ToNi3141/Rasterix/screenshots/qtRasterizer.png

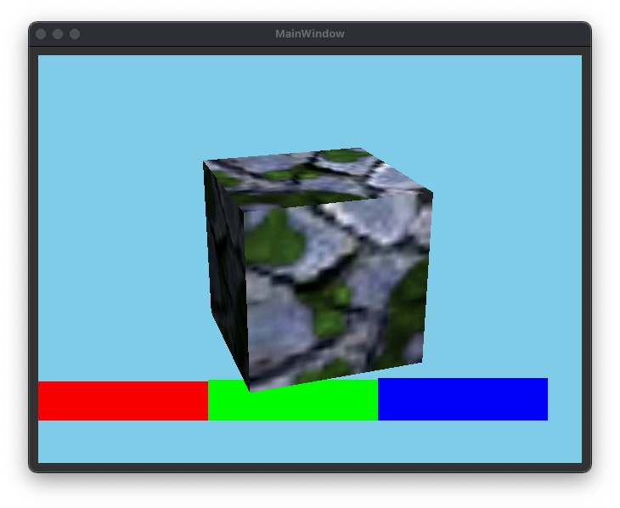
screenshots/qtRasterizer.png
