ToNi3141/Rasterix/screenshots/tuxracerRace.png

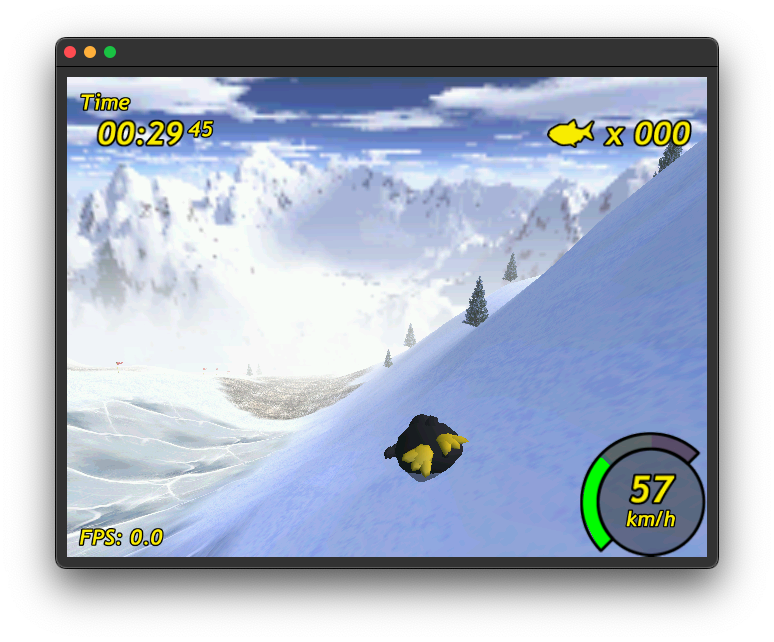
screenshots/tuxracerRace.png
