ToNi3141/Rasterix/screenshots/tuxracerRaceSelect.png

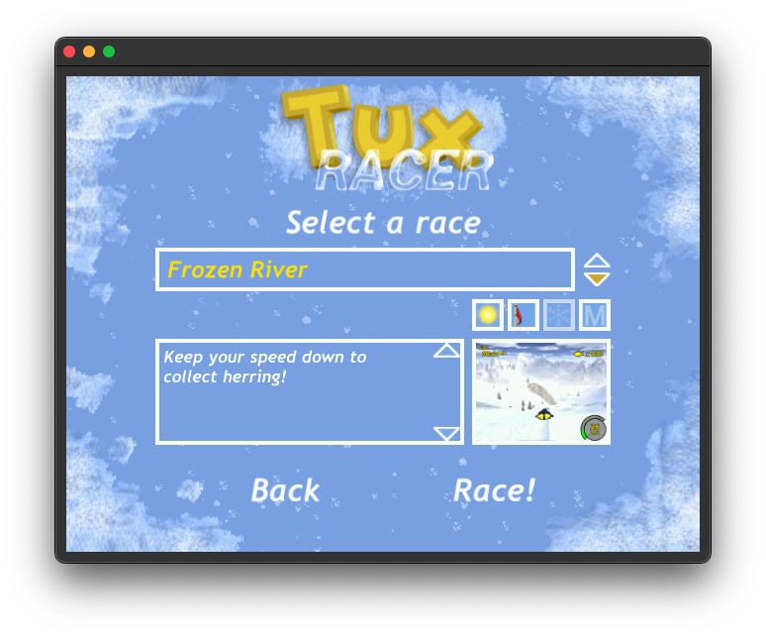
screenshots/tuxracerRaceSelect.png
