ToNi3141/Rasterix/(threads)

Thread 97 (2025-07-27):

Multiple display support, and PCIe driver

Kurapikov, 2025-07-27:
Hi ToNi3141,

I'd like to try this great project into my X64 w/ Virtex Ultrascale+ platform. Debian 12 running on X64, and the FPGA connect to X64 with PCIe Gen3 x8.

I've readed some documents in the project, and have two questions:

1. The documents no mentioned about multiple display support. Is it possible to expand? there's at least three monitors in my system and the resolution is 4k, 1080p and 720p. The drawing is not heavy, only UI and OSD. Three instance of RasterIX would be a waste of resource, IMHO.

2. Which example driver is closest to PCI express? I'm not a specialist to PCI express and kernel driver. To my knowledge, I should read the DMA proxy driver and Xilinx XDMA driver to write my one driver?

Thanks for your contribution and looking forward for your kindly reply.

BR.

ToNi3141, 2025-07-27:
Hi,
thank you for yor interest
1. Multiple displays are crrently not implemented. In theory, the hardware should be capable, adresses to the framebuffers are set via software commands, but the library itself can only draw to one context and one display. Please note that the maximum resolution is 2047x2047. 1080p should be possible (I never tested it) but 4k is not.
2. Hard to say. The DMA Proxy stuff is only useful when you want to use this project native on a Zynq or Microblaze design. The DMA Proxy is basically a driver to communicate with a DMA hardware like the CDMA from Xilinx. I guess the [ft60x ](https://github.com/ToNi3141/RasterIX/tree/main/lib/driver/ft60x) or the [raspberry pi pico example](https://github.com/ToNi3141/RasterIX/blob/main/example/util/rp-pico/Runner.hpp) should come closest to what you want.You only need a driver, which is capable to send a buffer from your Linux System via PCI to an 32Bit AXI Stream interface. More is not needed.

I hope I could help you.
Greetings
