ToNi3141/Rasterix/rtl/RasterIX/RasterIX_EF.v

// RasterIX
// https://github.com/ToNi3141/RasterIX
// Copyright (c) 2024 ToNi3141

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
module RasterIX_EF #(
    // The internal calculation width of a sub pixel
    parameter SUB_PIXEL_CALC_PRECISION = 8,

    // This enables the 4 bit stencil buffer
    parameter ENABLE_STENCIL_BUFFER = 1,

    // Enables the depth buffer
    parameter ENABLE_DEPTH_BUFFER = 1,

    // Number of TMUs. Currently supported values: 1 and 2
    parameter TMU_COUNT = 2,
    parameter ENABLE_MIPMAPPING = 1,
    parameter ENABLE_TEXTURE_FILTERING = 1,
    parameter TEXTURE_PAGE_SIZE = 2048,
    parameter ENABLE_EXTERNAL_TEXTURE_MEMORY = 0,
    parameter CACHE_SIZE = 1024,

    // Enables the fog unit
    parameter ENABLE_FOG = 1,

    // The maximum size of a texture
    parameter MAX_TEXTURE_SIZE = 256,

    // Memory address width
    parameter ADDR_WIDTH = 32,
    // Memory ID width
    parameter ID_WIDTH = 8,
    // Memory data width
    parameter DATA_WIDTH = 32,
    // Memory strobe width
    parameter STRB_WIDTH = DATA_WIDTH / 8,
    // Enable coalescing of the memory beats. This can significantly improve the throughput.
    parameter ENABLE_MEMORY_COALESCING = 1,

    // Configures the precision of the float calculations (interpolation of textures, depth, ...)
    // A lower value can significant reduce the logic consumption but can cause visible 
    // distortions in the rendered image.
    // 4 bit reducing can safe around 1k LUTs.
    // For compatibility reasons, it only cuts of the mantissa. By default it uses a 25x25 multiplier (for floatMul)
    // If you have a FPGA with only 18 bit native multipliers, reduce this value to 26.
    parameter RASTERIZER_FLOAT_PRECISION = 32,
    // When RASTERIZER_ENABLE_FLOAT_INTERPOLATION is 0, then this configures the width of the multipliers for the fix point
    // calculations. A value of 25 will instantiate signed 25 bit multipliers. The 25 already including the sign bit.
    // Lower values can lead to distortions of the fog and texels.
    parameter RASTERIZER_FIXPOINT_PRECISION = 25,
    // Enables the floating point interpolation. If this is disabled, it falls back
    // to the fix point interpolation
    parameter RASTERIZER_ENABLE_FLOAT_INTERPOLATION = 0,

    localparam CMD_STREAM_WIDTH = 32,
    localparam FB_SIZE_IN_PIXEL_LG = 20
)
(
    input  wire                             aclk,
    input  wire                             resetn,

    // AXI Stream command interface
    input  wire                             s_cmd_axis_tvalid,
    output wire                             s_cmd_axis_tready,
    input  wire                             s_cmd_axis_tlast,
    input  wire [CMD_STREAM_WIDTH - 1 : 0]  s_cmd_axis_tdata,

    // AXI Stream command response interface
    output wire                             m_cmd_resp_axis_tvalid,
    input  wire                             m_cmd_resp_axis_tready,
    output wire                             m_cmd_resp_axis_tlast,
    output wire [CMD_STREAM_WIDTH - 1 : 0]  m_cmd_resp_axis_tdata,

    // Framebuffer
    output wire                             swap_fb,
    output wire                             swap_fb_enable_vsync,
    output wire [ADDR_WIDTH - 1 : 0]        fb_addr,
    output wire [FB_SIZE_IN_PIXEL_LG - 1 : 0] fb_size,
    input  wire                             fb_swapped,

    // Memory Interface
    output wire [ID_WIDTH - 1 : 0]          m_axi_awid,
    output wire [ADDR_WIDTH - 1 : 0]        m_axi_awaddr,
    output wire [ 7 : 0]                    m_axi_awlen,
    output wire [ 2 : 0]                    m_axi_awsize,
    output wire [ 1 : 0]                    m_axi_awburst,
    output wire                             m_axi_awlock,
    output wire [ 3 : 0]                    m_axi_awcache,
    output wire [ 2 : 0]                    m_axi_awprot,
    output wire                             m_axi_awvalid,
    input  wire                             m_axi_awready,
    output wire [DATA_WIDTH - 1 : 0]        m_axi_wdata,
    output wire [STRB_WIDTH - 1 : 0]        m_axi_wstrb,
    output wire                             m_axi_wlast,
    output wire                             m_axi_wvalid,
    input  wire                             m_axi_wready,
    input  wire [ID_WIDTH - 1 : 0]          m_axi_bid,
    input  wire [ 1 : 0]                    m_axi_bresp,
    input  wire                             m_axi_bvalid,
    output wire                             m_axi_bready,
    output wire [ID_WIDTH - 1 : 0]          m_axi_arid,
    output wire [ADDR_WIDTH - 1 : 0]        m_axi_araddr,
    output wire [ 7 : 0]                    m_axi_arlen,
    output wire [ 2 : 0]                    m_axi_arsize,
    output wire [ 1 : 0]                    m_axi_arburst,
    output wire                             m_axi_arlock,
    output wire [ 3 : 0]                    m_axi_arcache,
    output wire [ 2 : 0]                    m_axi_arprot,
    output wire                             m_axi_arvalid,
    input  wire                             m_axi_arready,
    input  wire [ID_WIDTH - 1 : 0]          m_axi_rid,
    input  wire [DATA_WIDTH - 1 : 0]        m_axi_rdata,
    input  wire [ 1 : 0]                    m_axi_rresp,
    input  wire                             m_axi_rlast,
    input  wire                             m_axi_rvalid,
    output wire                             m_axi_rready,

    // Performance signals
    output wire                             perfBusy,
    output wire                             perfTriangleRendering,
    output wire                             perfRasterizerStall
);
    localparam ID_WIDTH_LOC = ID_WIDTH - 3;
    localparam NRS = 6;

    initial
    begin
        if (ID_WIDTH < 4)
        begin
            $error("ID_WIDTH must be at least 4");
        end
    end

    wire [(NRS * ID_WIDTH_LOC) - 1 : 0]     xbar_axi_awid;
    wire [(NRS * ADDR_WIDTH) - 1 : 0]       xbar_axi_awaddr;
    wire [(NRS * 8) - 1 : 0]                xbar_axi_awlen; 
    wire [(NRS * 3) - 1 : 0]                xbar_axi_awsize;
    wire [(NRS * 2) - 1 : 0]                xbar_axi_awburst;
    wire [NRS - 1 : 0]                      xbar_axi_awlock;
    wire [(NRS * 4) - 1 : 0]                xbar_axi_awcache;
    wire [(NRS * 3) - 1 : 0]                xbar_axi_awprot; 
    wire [NRS - 1 : 0]                      xbar_axi_awvalid;
    wire [NRS - 1 : 0]                      xbar_axi_awready;

    wire [(NRS * DATA_WIDTH) - 1 : 0]       xbar_axi_wdata;
    wire [(NRS * STRB_WIDTH) - 1 : 0]       xbar_axi_wstrb;
    wire [NRS - 1 : 0]                      xbar_axi_wlast;
    wire [NRS - 1 : 0]                      xbar_axi_wvalid;
    wire [NRS - 1 : 0]                      xbar_axi_wready;

    wire [(NRS * ID_WIDTH_LOC) - 1 : 0]     xbar_axi_bid;
    wire [(NRS * 2) - 1 : 0]                xbar_axi_bresp;
    wire [NRS - 1 : 0]                      xbar_axi_bvalid;
    wire [NRS - 1 : 0]                      xbar_axi_bready;

    wire [(NRS * ID_WIDTH_LOC) - 1 : 0]     xbar_axi_arid;
    wire [(NRS * ADDR_WIDTH) - 1 : 0]       xbar_axi_araddr;
    wire [(NRS * 8) - 1 : 0]                xbar_axi_arlen;
    wire [(NRS * 3) - 1 : 0]                xbar_axi_arsize;
    wire [(NRS * 2) - 1 : 0]                xbar_axi_arburst;
    wire [NRS - 1 : 0]                      xbar_axi_arlock;
    wire [(NRS * 4) - 1 : 0]                xbar_axi_arcache;
    wire [(NRS * 3) - 1 : 0]                xbar_axi_arprot;
    wire [NRS - 1 : 0]                      xbar_axi_arvalid;
    wire [NRS - 1 : 0]                      xbar_axi_arready;

    wire [(NRS * ID_WIDTH_LOC) - 1 : 0]     xbar_axi_rid;
    wire [(NRS * DATA_WIDTH) - 1 : 0]       xbar_axi_rdata;
    wire [(NRS * 2) - 1 : 0]                xbar_axi_rresp;
    wire [NRS - 1 : 0]                      xbar_axi_rlast;
    wire [NRS - 1 : 0]                      xbar_axi_rvalid;
    wire [NRS - 1 : 0]                      xbar_axi_rready;

    axi_crossbar #(
        .DATA_WIDTH(DATA_WIDTH),
        .ADDR_WIDTH(ADDR_WIDTH),
        .S_ID_WIDTH(ID_WIDTH_LOC),
        .S_COUNT(NRS),
        .M_COUNT(1),
        .M_ID_WIDTH(ID_WIDTH),
        .M_ADDR_WIDTH(ADDR_WIDTH[0 +: 32]),
        .S_THREADS({ NRS { 32'd1 } }),
        .M_ISSUE(32'd8) // Best tradeoff between performance and utilization
    ) mainXBar (
        .clk(aclk),
        .rst(!resetn),

        .s_axi_awid(xbar_axi_awid),
        .s_axi_awaddr(xbar_axi_awaddr),
        .s_axi_awlen(xbar_axi_awlen),
        .s_axi_awsize(xbar_axi_awsize),
        .s_axi_awburst(xbar_axi_awburst),
        .s_axi_awlock(xbar_axi_awlock),
        .s_axi_awcache(xbar_axi_awcache),
        .s_axi_awprot(xbar_axi_awprot),
        .s_axi_awqos(0),
        .s_axi_awuser(0),
        .s_axi_awvalid(xbar_axi_awvalid),
        .s_axi_awready(xbar_axi_awready),

        .s_axi_wdata(xbar_axi_wdata),
        .s_axi_wstrb(xbar_axi_wstrb),
        .s_axi_wlast(xbar_axi_wlast),
        .s_axi_wuser(0),
        .s_axi_wvalid(xbar_axi_wvalid),
        .s_axi_wready(xbar_axi_wready),

        .s_axi_bid(xbar_axi_bid),
        .s_axi_bresp(xbar_axi_bresp),
        .s_axi_buser(),
        .s_axi_bvalid(xbar_axi_bvalid),
        .s_axi_bready(xbar_axi_bready),

        .s_axi_arid(xbar_axi_arid),
        .s_axi_araddr(xbar_axi_araddr),
        .s_axi_arlen(xbar_axi_arlen),
        .s_axi_arsize(xbar_axi_arsize),
        .s_axi_arburst(xbar_axi_arburst),
        .s_axi_arlock(xbar_axi_arlock),
        .s_axi_arcache(xbar_axi_arcache),
        .s_axi_arprot(xbar_axi_arprot),
        .s_axi_arqos(0),
        .s_axi_aruser(0),
        .s_axi_arvalid(xbar_axi_arvalid),
        .s_axi_arready(xbar_axi_arready),

        .s_axi_rid(xbar_axi_rid),
        .s_axi_rdata(xbar_axi_rdata),
        .s_axi_rresp(xbar_axi_rresp),
        .s_axi_rlast(xbar_axi_rlast),
        .s_axi_ruser(),
        .s_axi_rvalid(xbar_axi_rvalid),
        .s_axi_rready(xbar_axi_rready),

        .m_axi_awid(m_axi_awid),
        .m_axi_awaddr(m_axi_awaddr),
        .m_axi_awlen(m_axi_awlen),
        .m_axi_awsize(m_axi_awsize),
        .m_axi_awburst(m_axi_awburst),
        .m_axi_awlock(m_axi_awlock),
        .m_axi_awcache(m_axi_awcache),
        .m_axi_awprot(m_axi_awprot),
        .m_axi_awqos(),
        .m_axi_awregion(),
        .m_axi_awuser(),
        .m_axi_awvalid(m_axi_awvalid),
        .m_axi_awready(m_axi_awready),

        .m_axi_wdata(m_axi_wdata),
        .m_axi_wstrb(m_axi_wstrb),
        .m_axi_wlast(m_axi_wlast),
        .m_axi_wuser(),
        .m_axi_wvalid(m_axi_wvalid),
        .m_axi_wready(m_axi_wready),

        .m_axi_bid(m_axi_bid),
        .m_axi_bresp(m_axi_bresp),
        .m_axi_buser(0),
        .m_axi_bvalid(m_axi_bvalid),
        .m_axi_bready(m_axi_bready),

        .m_axi_arid(m_axi_arid),
        .m_axi_araddr(m_axi_araddr),
        .m_axi_arlen(m_axi_arlen),
        .m_axi_arsize(m_axi_arsize),
        .m_axi_arburst(m_axi_arburst),
        .m_axi_arlock(m_axi_arlock),
        .m_axi_arcache(m_axi_arcache),
        .m_axi_arqos(),
        .m_axi_arregion(),
        .m_axi_aruser(),
        .m_axi_arprot(m_axi_arprot),
        .m_axi_arvalid(m_axi_arvalid),
        .m_axi_arready(m_axi_arready),

        .m_axi_rid(m_axi_rid),
        .m_axi_rdata(m_axi_rdata),
        .m_axi_rresp(m_axi_rresp),
        .m_axi_rlast(m_axi_rlast),
        .m_axi_ruser(0),
        .m_axi_rvalid(m_axi_rvalid),
        .m_axi_rready(m_axi_rready)
    );

    localparam CMD_STREAM_STRB_WIDTH = CMD_STREAM_WIDTH / 8;
    wire [ID_WIDTH_LOC - 1 : 0]             common_axi_awid;
    wire [ADDR_WIDTH - 1 : 0]               common_axi_awaddr;
    wire [ 7 : 0]                           common_axi_awlen;
    wire [ 2 : 0]                           common_axi_awsize;
    wire [ 1 : 0]                           common_axi_awburst;
    wire                                    common_axi_awlock;
    wire [ 3 : 0]                           common_axi_awcache;
    wire [ 2 : 0]                           common_axi_awprot;
    wire                                    common_axi_awvalid;
    wire                                    common_axi_awready;
    wire [CMD_STREAM_WIDTH - 1 : 0]         common_axi_wdata;
    wire [CMD_STREAM_STRB_WIDTH - 1 : 0]    common_axi_wstrb;
    wire                                    common_axi_wlast;
    wire                                    common_axi_wvalid;
    wire                                    common_axi_wready;
    wire [ID_WIDTH_LOC - 1 : 0]             common_axi_bid;
    wire [ 1 : 0]                           common_axi_bresp;
    wire                                    common_axi_bvalid;
    wire                                    common_axi_bready;
    wire [ID_WIDTH_LOC - 1 : 0]             common_axi_arid;
    wire [ADDR_WIDTH - 1 : 0]               common_axi_araddr;
    wire [ 7 : 0]                           common_axi_arlen;
    wire [ 2 : 0]                           common_axi_arsize;
    wire [ 1 : 0]                           common_axi_arburst;
    wire                                    common_axi_arlock;
    wire [ 3 : 0]                           common_axi_arcache;
    wire [ 2 : 0]                           common_axi_arprot;
    wire                                    common_axi_arvalid;
    wire                                    common_axi_arready;
    wire [ID_WIDTH_LOC - 1 : 0]             common_axi_rid;
    wire [CMD_STREAM_WIDTH - 1 : 0]         common_axi_rdata;
    wire [ 1 : 0]                           common_axi_rresp;
    wire                                    common_axi_rlast;
    wire                                    common_axi_rvalid;
    wire                                    common_axi_rready;

    axi_adapter #(
        .ADDR_WIDTH(ADDR_WIDTH),
        .M_DATA_WIDTH(DATA_WIDTH),
        .M_STRB_WIDTH(STRB_WIDTH),
        .S_DATA_WIDTH(CMD_STREAM_WIDTH),
        .S_STRB_WIDTH(CMD_STREAM_STRB_WIDTH),
        .ID_WIDTH(ID_WIDTH_LOC),
        .CONVERT_BURST(1),
        .CONVERT_NARROW_BURST(1)
    ) commonAxiAdapter (
        .clk(aclk),
        .rst(!resetn),

        .m_axi_awid(xbar_axi_awid[0 * ID_WIDTH_LOC +: ID_WIDTH_LOC]),
        .m_axi_awaddr(xbar_axi_awaddr[0 * ADDR_WIDTH +: ADDR_WIDTH]),
        .m_axi_awlen(xbar_axi_awlen[0 * 8 +: 8]),
        .m_axi_awsize(xbar_axi_awsize[0 * 3 +: 3]),
        .m_axi_awburst(xbar_axi_awburst[0 * 2 +: 2]),
        .m_axi_awlock(xbar_axi_awlock[0 * 1 +: 1]),
        .m_axi_awcache(xbar_axi_awcache[0 * 4 +: 4]),
        .m_axi_awprot(xbar_axi_awprot[0 * 3 +: 3]),
        .m_axi_awqos(),
        .m_axi_awregion(),
        .m_axi_awuser(),
        .m_axi_awvalid(xbar_axi_awvalid[0 * 1 +: 1]),
        .m_axi_awready(xbar_axi_awready[0 * 1 +: 1]),
        .m_axi_wdata(xbar_axi_wdata[0 * DATA_WIDTH +: DATA_WIDTH]),
        .m_axi_wstrb(xbar_axi_wstrb[0 * STRB_WIDTH +: STRB_WIDTH]),
        .m_axi_wlast(xbar_axi_wlast[0 * 1 +: 1]),
        .m_axi_wuser(),
        .m_axi_wvalid(xbar_axi_wvalid[0 * 1 +: 1]),
        .m_axi_wready(xbar_axi_wready[0 * 1 +: 1]),
        .m_axi_bid(xbar_axi_bid[0 * ID_WIDTH_LOC +: ID_WIDTH_LOC]),
        .m_axi_bresp(xbar_axi_bresp[0 * 2 +: 2]),
        .m_axi_buser(0),
        .m_axi_bvalid(xbar_axi_bvalid[0 * 1 +: 1]),
        .m_axi_bready(xbar_axi_bready[0 * 1 +: 1]),
        .m_axi_arid(xbar_axi_arid[0 * ID_WIDTH_LOC +: ID_WIDTH_LOC]),
        .m_axi_araddr(xbar_axi_araddr[0 * ADDR_WIDTH +: ADDR_WIDTH]),
        .m_axi_arlen(xbar_axi_arlen[0 * 8 +: 8]),
        .m_axi_arsize(xbar_axi_arsize[0 * 3 +: 3]),
        .m_axi_arburst(xbar_axi_arburst[0 * 2 +: 2]),
        .m_axi_arlock(xbar_axi_arlock[0 * 1 +: 1]),
        .m_axi_arcache(xbar_axi_arcache[0 * 4 +: 4]),
        .m_axi_arprot(xbar_axi_arprot[0 * 3 +: 3]),
        .m_axi_arqos(),
        .m_axi_arregion(),
        .m_axi_aruser(),
        .m_axi_arvalid(xbar_axi_arvalid[0 * 1 +: 1]),
        .m_axi_arready(xbar_axi_arready[0 * 1 +: 1]),
        .m_axi_rid(xbar_axi_rid[0 * ID_WIDTH_LOC +: ID_WIDTH_LOC]),
        .m_axi_rdata(xbar_axi_rdata[0 * DATA_WIDTH +: DATA_WIDTH]),
        .m_axi_rresp(xbar_axi_rresp[0 * 2 +: 2]),
        .m_axi_rlast(xbar_axi_rlast[0 * 1 +: 1]),
        .m_axi_ruser(0),
        .m_axi_rvalid(xbar_axi_rvalid[0 * 1 +: 1]),
        .m_axi_rready(xbar_axi_rready[0 * 1 +: 1]),

        .s_axi_awid(common_axi_awid),
        .s_axi_awaddr(common_axi_awaddr),
        .s_axi_awlen(common_axi_awlen),
        .s_axi_awsize(common_axi_awsize),
        .s_axi_awburst(common_axi_awburst),
        .s_axi_awlock(common_axi_awlock),
        .s_axi_awcache(common_axi_awcache),
        .s_axi_awprot(common_axi_awprot),
        .s_axi_awqos(0),
        .s_axi_awregion(0),
        .s_axi_awuser(0),
        .s_axi_awvalid(common_axi_awvalid),
        .s_axi_awready(common_axi_awready),
        .s_axi_wdata(common_axi_wdata),
        .s_axi_wstrb(common_axi_wstrb),
        .s_axi_wlast(common_axi_wlast),
        .s_axi_wuser(0),
        .s_axi_wvalid(common_axi_wvalid),
        .s_axi_wready(common_axi_wready),
        .s_axi_bid(common_axi_bid),
        .s_axi_bresp(common_axi_bresp),
        .s_axi_buser(),
        .s_axi_bvalid(common_axi_bvalid),
        .s_axi_bready(common_axi_bready),
        .s_axi_arid(common_axi_arid),
        .s_axi_araddr(common_axi_araddr),
        .s_axi_arlen(common_axi_arlen),
        .s_axi_arsize(common_axi_arsize),
        .s_axi_arburst(common_axi_arburst),
        .s_axi_arlock(common_axi_arlock),
        .s_axi_arcache(common_axi_arcache),
        .s_axi_arprot(common_axi_arprot),
        .s_axi_arqos(0),
        .s_axi_arregion(0),
        .s_axi_aruser(0),
        .s_axi_arvalid(common_axi_arvalid),
        .s_axi_arready(common_axi_arready),
        .s_axi_rid(common_axi_rid),
        .s_axi_rdata(common_axi_rdata),
        .s_axi_rresp(common_axi_rresp),
        .s_axi_rlast(common_axi_rlast),
        .s_axi_ruser(),
        .s_axi_rvalid(common_axi_rvalid),
        .s_axi_rready(common_axi_rready)
    );

    wire                             cmd_axis_tvalid;
    wire                             cmd_axis_tready;
    wire                             cmd_axis_tlast;
    wire [CMD_STREAM_WIDTH - 1 : 0]  cmd_axis_tdata;

    FrameStreamingCore #(
        .STREAM_WIDTH(CMD_STREAM_WIDTH),
        .ADDR_WIDTH(ADDR_WIDTH),
        .ID_WIDTH(ID_WIDTH_LOC)
    ) dma (
        .aclk(aclk),
        .resetn(resetn),

        .m_st1_axis_tvalid(cmd_axis_tvalid),
        .m_st1_axis_tready(cmd_axis_tready),
        .m_st1_axis_tlast(cmd_axis_tlast),
        .m_st1_axis_tdata(cmd_axis_tdata),

        .s_st1_axis_tvalid(0),
        .s_st1_axis_tready(),
        .s_st1_axis_tlast(0),
        .s_st1_axis_tdata(0),

        .m_st0_axis_tvalid(m_cmd_resp_axis_tvalid),
        .m_st0_axis_tready(m_cmd_resp_axis_tready),
        .m_st0_axis_tlast(m_cmd_resp_axis_tlast),
        .m_st0_axis_tdata(m_cmd_resp_axis_tdata),

        .s_st0_axis_tvalid(s_cmd_axis_tvalid),
        .s_st0_axis_tready(s_cmd_axis_tready),
        .s_st0_axis_tlast(s_cmd_axis_tlast),
        .s_st0_axis_tdata(s_cmd_axis_tdata),

        .m_mem_axi_awid(common_axi_awid),
        .m_mem_axi_awaddr(common_axi_awaddr),
        .m_mem_axi_awlen(common_axi_awlen), 
        .m_mem_axi_awsize(common_axi_awsize), 
        .m_mem_axi_awburst(common_axi_awburst), 
        .m_mem_axi_awlock(common_axi_awlock), 
        .m_mem_axi_awcache(common_axi_awcache), 
        .m_mem_axi_awprot(common_axi_awprot), 
        .m_mem_axi_awvalid(common_axi_awvalid),
        .m_mem_axi_awready(common_axi_awready),

        .m_mem_axi_wdata(common_axi_wdata),
        .m_mem_axi_wstrb(common_axi_wstrb),
        .m_mem_axi_wlast(common_axi_wlast),
        .m_mem_axi_wvalid(common_axi_wvalid),
        .m_mem_axi_wready(common_axi_wready),

        .m_mem_axi_bid(common_axi_bid),
        .m_mem_axi_bresp(common_axi_bresp),
        .m_mem_axi_bvalid(common_axi_bvalid),
        .m_mem_axi_bready(common_axi_bready),

        .m_mem_axi_arid(common_axi_arid),
        .m_mem_axi_araddr(common_axi_araddr),
        .m_mem_axi_arlen(common_axi_arlen),
        .m_mem_axi_arsize(common_axi_arsize),
        .m_mem_axi_arburst(common_axi_arburst),
        .m_mem_axi_arlock(common_axi_arlock),
        .m_mem_axi_arcache(common_axi_arcache),
        .m_mem_axi_arprot(common_axi_arprot),
        .m_mem_axi_arvalid(common_axi_arvalid),
        .m_mem_axi_arready(common_axi_arready),

        .m_mem_axi_rid(common_axi_rid),
        .m_mem_axi_rdata(common_axi_rdata),
        .m_mem_axi_rresp(common_axi_rresp),
        .m_mem_axi_rlast(common_axi_rlast),
        .m_mem_axi_rvalid(common_axi_rvalid),
        .m_mem_axi_rready(common_axi_rready)
    );

    RasterIXCoreEF #(
        .TEXTURE_PAGE_SIZE(TEXTURE_PAGE_SIZE),
        .ADDR_WIDTH(ADDR_WIDTH),
        .ID_WIDTH(ID_WIDTH_LOC),
        .DATA_WIDTH(DATA_WIDTH),
        .SUB_PIXEL_CALC_PRECISION(SUB_PIXEL_CALC_PRECISION),
        .ENABLE_STENCIL_BUFFER(ENABLE_STENCIL_BUFFER),
        .ENABLE_DEPTH_BUFFER(ENABLE_DEPTH_BUFFER),
        .MAX_TEXTURE_SIZE(MAX_TEXTURE_SIZE),
        .ENABLE_MIPMAPPING(ENABLE_MIPMAPPING),
        .ENABLE_TEXTURE_FILTERING(ENABLE_TEXTURE_FILTERING),
        .ENABLE_EXTERNAL_TEXTURE_MEMORY(ENABLE_EXTERNAL_TEXTURE_MEMORY),
        .CACHE_SIZE(CACHE_SIZE),
        .ENABLE_FOG(ENABLE_FOG),
        .TMU_COUNT(TMU_COUNT),
        .RASTERIZER_ENABLE_FLOAT_INTERPOLATION(RASTERIZER_ENABLE_FLOAT_INTERPOLATION),
        .RASTERIZER_FLOAT_PRECISION(RASTERIZER_FLOAT_PRECISION),
        .RASTERIZER_FIXPOINT_PRECISION(RASTERIZER_FIXPOINT_PRECISION),
        .ENABLE_MEMORY_COALESCING(ENABLE_MEMORY_COALESCING)
    ) rixef (
        .aclk(aclk),
        .resetn(resetn),
        
        .s_cmd_axis_tvalid(cmd_axis_tvalid),
        .s_cmd_axis_tready(cmd_axis_tready),
        .s_cmd_axis_tlast(cmd_axis_tlast),
        .s_cmd_axis_tdata(cmd_axis_tdata),

        .swap_fb(swap_fb),
        .swap_fb_enable_vsync(swap_fb_enable_vsync),
        .fb_addr(fb_addr),
        .fb_size(fb_size),
        .fb_swapped(fb_swapped),

        .m_color_axi_awid(xbar_axi_awid[1 * ID_WIDTH_LOC +: ID_WIDTH_LOC]),
        .m_color_axi_awaddr(xbar_axi_awaddr[1 * ADDR_WIDTH +: ADDR_WIDTH]),
        .m_color_axi_awlen(xbar_axi_awlen[1 * 8 +: 8]),
        .m_color_axi_awsize(xbar_axi_awsize[1 * 3 +: 3]),
        .m_color_axi_awburst(xbar_axi_awburst[1 * 2 +: 2]),
        .m_color_axi_awlock(xbar_axi_awlock[1 * 1 +: 1]),
        .m_color_axi_awcache(xbar_axi_awcache[1 * 4 +: 4]),
        .m_color_axi_awprot(xbar_axi_awprot[1 * 3 +: 3]),
        .m_color_axi_awvalid(xbar_axi_awvalid[1 * 1 +: 1]),
        .m_color_axi_awready(xbar_axi_awready[1 * 1 +: 1]),

        .m_color_axi_wdata(xbar_axi_wdata[1 * DATA_WIDTH +: DATA_WIDTH]),
        .m_color_axi_wstrb(xbar_axi_wstrb[1 * STRB_WIDTH +: STRB_WIDTH]),
        .m_color_axi_wlast(xbar_axi_wlast[1 * 1 +: 1]),
        .m_color_axi_wvalid(xbar_axi_wvalid[1 * 1 +: 1]),
        .m_color_axi_wready(xbar_axi_wready[1 * 1 +: 1]),

        .m_color_axi_bid(xbar_axi_bid[1 * ID_WIDTH_LOC +: ID_WIDTH_LOC]),
        .m_color_axi_bresp(xbar_axi_bresp[1 * 2 +: 2]),
        .m_color_axi_bvalid(xbar_axi_bvalid[1 * 1 +: 1]),
        .m_color_axi_bready(xbar_axi_bready[1 * 1 +: 1]),

        .m_color_axi_arid(xbar_axi_arid[1 * ID_WIDTH_LOC +: ID_WIDTH_LOC]),
        .m_color_axi_araddr(xbar_axi_araddr[1 * ADDR_WIDTH +: ADDR_WIDTH]),
        .m_color_axi_arlen(xbar_axi_arlen[1 * 8 +: 8]),
        .m_color_axi_arsize(xbar_axi_arsize[1 * 3 +: 3]),
        .m_color_axi_arburst(xbar_axi_arburst[1 * 2 +: 2]),
        .m_color_axi_arlock(xbar_axi_arlock[1 * 1 +: 1]),
        .m_color_axi_arcache(xbar_axi_arcache[1 * 4 +: 4]),
        .m_color_axi_arprot(xbar_axi_arprot[1 * 3 +: 3]),
        .m_color_axi_arvalid(xbar_axi_arvalid[1 * 1 +: 1]),
        .m_color_axi_arready(xbar_axi_arready[1 * 1 +: 1]),

        .m_color_axi_rid(xbar_axi_rid[1 * ID_WIDTH_LOC +: ID_WIDTH_LOC]),
        .m_color_axi_rdata(xbar_axi_rdata[1 * DATA_WIDTH +: DATA_WIDTH]),
        .m_color_axi_rresp(xbar_axi_rresp[1 * 2 +: 2]),
        .m_color_axi_rlast(xbar_axi_rlast[1 * 1 +: 1]),
        .m_color_axi_rvalid(xbar_axi_rvalid[1 * 1 +: 1]),
        .m_color_axi_rready(xbar_axi_rready[1 * 1 +: 1]),

        .m_depth_axi_awid(xbar_axi_awid[2 * ID_WIDTH_LOC +: ID_WIDTH_LOC]),
        .m_depth_axi_awaddr(xbar_axi_awaddr[2 * ADDR_WIDTH +: ADDR_WIDTH]),
        .m_depth_axi_awlen(xbar_axi_awlen[2 * 8 +: 8]),
        .m_depth_axi_awsize(xbar_axi_awsize[2 * 3 +: 3]),
        .m_depth_axi_awburst(xbar_axi_awburst[2 * 2 +: 2]),
        .m_depth_axi_awlock(xbar_axi_awlock[2 * 1 +: 1]),
        .m_depth_axi_awcache(xbar_axi_awcache[2 * 4 +: 4]),
        .m_depth_axi_awprot(xbar_axi_awprot[2 * 3 +: 3]),
        .m_depth_axi_awvalid(xbar_axi_awvalid[2 * 1 +: 1]),
        .m_depth_axi_awready(xbar_axi_awready[2 * 1 +: 1]),

        .m_depth_axi_wdata(xbar_axi_wdata[2 * DATA_WIDTH +: DATA_WIDTH]),
        .m_depth_axi_wstrb(xbar_axi_wstrb[2 * STRB_WIDTH +: STRB_WIDTH]),
        .m_depth_axi_wlast(xbar_axi_wlast[2 * 1 +: 1]),
        .m_depth_axi_wvalid(xbar_axi_wvalid[2 * 1 +: 1]),
        .m_depth_axi_wready(xbar_axi_wready[2 * 1 +: 1]),

        .m_depth_axi_bid(xbar_axi_bid[2 * ID_WIDTH_LOC +: ID_WIDTH_LOC]),
        .m_depth_axi_bresp(xbar_axi_bresp[2 * 2 +: 2]),
        .m_depth_axi_bvalid(xbar_axi_bvalid[2 * 1 +: 1]),
        .m_depth_axi_bready(xbar_axi_bready[2 * 1 +: 1]),

        .m_depth_axi_arid(xbar_axi_arid[2 * ID_WIDTH_LOC +: ID_WIDTH_LOC]),
        .m_depth_axi_araddr(xbar_axi_araddr[2 * ADDR_WIDTH +: ADDR_WIDTH]),
        .m_depth_axi_arlen(xbar_axi_arlen[2 * 8 +: 8]),
        .m_depth_axi_arsize(xbar_axi_arsize[2 * 3 +: 3]),
        .m_depth_axi_arburst(xbar_axi_arburst[2 * 2 +: 2]),
        .m_depth_axi_arlock(xbar_axi_arlock[2 * 1 +: 1]),
        .m_depth_axi_arcache(xbar_axi_arcache[2 * 4 +: 4]),
        .m_depth_axi_arprot(xbar_axi_arprot[2 * 3 +: 3]),
        .m_depth_axi_arvalid(xbar_axi_arvalid[2 * 1 +: 1]),
        .m_depth_axi_arready(xbar_axi_arready[2 * 1 +: 1]),

        .m_depth_axi_rid(xbar_axi_rid[2 * ID_WIDTH_LOC +: ID_WIDTH_LOC]),
        .m_depth_axi_rdata(xbar_axi_rdata[2 * DATA_WIDTH +: DATA_WIDTH]),
        .m_depth_axi_rresp(xbar_axi_rresp[2 * 2 +: 2]),
        .m_depth_axi_rlast(xbar_axi_rlast[2 * 1 +: 1]),
        .m_depth_axi_rvalid(xbar_axi_rvalid[2 * 1 +: 1]),
        .m_depth_axi_rready(xbar_axi_rready[2 * 1 +: 1]),

        .m_stencil_axi_awid(xbar_axi_awid[3 * ID_WIDTH_LOC +: ID_WIDTH_LOC]),
        .m_stencil_axi_awaddr(xbar_axi_awaddr[3 * ADDR_WIDTH +: ADDR_WIDTH]),
        .m_stencil_axi_awlen(xbar_axi_awlen[3 * 8 +: 8]),
        .m_stencil_axi_awsize(xbar_axi_awsize[3 * 3 +: 3]),
        .m_stencil_axi_awburst(xbar_axi_awburst[3 * 2 +: 2]),
        .m_stencil_axi_awlock(xbar_axi_awlock[3 * 1 +: 1]),
        .m_stencil_axi_awcache(xbar_axi_awcache[3 * 4 +: 4]),
        .m_stencil_axi_awprot(xbar_axi_awprot[3 * 3 +: 3]),
        .m_stencil_axi_awvalid(xbar_axi_awvalid[3 * 1 +: 1]),
        .m_stencil_axi_awready(xbar_axi_awready[3 * 1 +: 1]),

        .m_stencil_axi_wdata(xbar_axi_wdata[3 * DATA_WIDTH +: DATA_WIDTH]),
        .m_stencil_axi_wstrb(xbar_axi_wstrb[3 * STRB_WIDTH +: STRB_WIDTH]),
        .m_stencil_axi_wlast(xbar_axi_wlast[3 * 1 +: 1]),
        .m_stencil_axi_wvalid(xbar_axi_wvalid[3 * 1 +: 1]),
        .m_stencil_axi_wready(xbar_axi_wready[3 * 1 +: 1]),

        .m_stencil_axi_bid(xbar_axi_bid[3 * ID_WIDTH_LOC +: ID_WIDTH_LOC]),
        .m_stencil_axi_bresp(xbar_axi_bresp[3 * 2 +: 2]),
        .m_stencil_axi_bvalid(xbar_axi_bvalid[3 * 1 +: 1]),
        .m_stencil_axi_bready(xbar_axi_bready[3 * 1 +: 1]),

        .m_stencil_axi_arid(xbar_axi_arid[3 * ID_WIDTH_LOC +: ID_WIDTH_LOC]),
        .m_stencil_axi_araddr(xbar_axi_araddr[3 * ADDR_WIDTH +: ADDR_WIDTH]),
        .m_stencil_axi_arlen(xbar_axi_arlen[3 * 8 +: 8]),
        .m_stencil_axi_arsize(xbar_axi_arsize[3 * 3 +: 3]),
        .m_stencil_axi_arburst(xbar_axi_arburst[3 * 2 +: 2]),
        .m_stencil_axi_arlock(xbar_axi_arlock[3 * 1 +: 1]),
        .m_stencil_axi_arcache(xbar_axi_arcache[3 * 4 +: 4]),
        .m_stencil_axi_arprot(xbar_axi_arprot[3 * 3 +: 3]),
        .m_stencil_axi_arvalid(xbar_axi_arvalid[3 * 1 +: 1]),
        .m_stencil_axi_arready(xbar_axi_arready[3 * 1 +: 1]),

        .m_stencil_axi_rid(xbar_axi_rid[3 * ID_WIDTH_LOC +: ID_WIDTH_LOC]),
        .m_stencil_axi_rdata(xbar_axi_rdata[3 * DATA_WIDTH +: DATA_WIDTH]),
        .m_stencil_axi_rresp(xbar_axi_rresp[3 * 2 +: 2]),
        .m_stencil_axi_rlast(xbar_axi_rlast[3 * 1 +: 1]),
        .m_stencil_axi_rvalid(xbar_axi_rvalid[3 * 1 +: 1]),
        .m_stencil_axi_rready(xbar_axi_rready[3 * 1 +: 1]),

        .m_tmu0_axi_arid(xbar_axi_arid[4 * ID_WIDTH_LOC +: ID_WIDTH_LOC]),
        .m_tmu0_axi_araddr(xbar_axi_araddr[4 * ADDR_WIDTH +: ADDR_WIDTH]),
        .m_tmu0_axi_arlen(xbar_axi_arlen[4 * 8 +: 8]),
        .m_tmu0_axi_arsize(xbar_axi_arsize[4 * 3 +: 3]),
        .m_tmu0_axi_arburst(xbar_axi_arburst[4 * 2 +: 2]),
        .m_tmu0_axi_arlock(xbar_axi_arlock[4 * 1 +: 1]),
        .m_tmu0_axi_arcache(xbar_axi_arcache[4 * 4 +: 4]),
        .m_tmu0_axi_arprot(xbar_axi_arprot[4 * 3 +: 3]),
        .m_tmu0_axi_arvalid(xbar_axi_arvalid[4 * 1 +: 1]),
        .m_tmu0_axi_arready(xbar_axi_arready[4 * 1 +: 1]),

        .m_tmu0_axi_rid(xbar_axi_rid[4 * ID_WIDTH_LOC +: ID_WIDTH_LOC]),
        .m_tmu0_axi_rdata(xbar_axi_rdata[4 * DATA_WIDTH +: DATA_WIDTH]),
        .m_tmu0_axi_rresp(xbar_axi_rresp[4 * 2 +: 2]),
        .m_tmu0_axi_rlast(xbar_axi_rlast[4 * 1 +: 1]),
        .m_tmu0_axi_rvalid(xbar_axi_rvalid[4 * 1 +: 1]),
        .m_tmu0_axi_rready(xbar_axi_rready[4 * 1 +: 1]),

        .m_tmu1_axi_arid(xbar_axi_arid[5 * ID_WIDTH_LOC +: ID_WIDTH_LOC]),
        .m_tmu1_axi_araddr(xbar_axi_araddr[5 * ADDR_WIDTH +: ADDR_WIDTH]),
        .m_tmu1_axi_arlen(xbar_axi_arlen[5 * 8 +: 8]),
        .m_tmu1_axi_arsize(xbar_axi_arsize[5 * 3 +: 3]),
        .m_tmu1_axi_arburst(xbar_axi_arburst[5 * 2 +: 2]),
        .m_tmu1_axi_arlock(xbar_axi_arlock[5 * 1 +: 1]),
        .m_tmu1_axi_arcache(xbar_axi_arcache[5 * 4 +: 4]),
        .m_tmu1_axi_arprot(xbar_axi_arprot[5 * 3 +: 3]),
        .m_tmu1_axi_arvalid(xbar_axi_arvalid[5 * 1 +: 1]),
        .m_tmu1_axi_arready(xbar_axi_arready[5 * 1 +: 1]),

        .m_tmu1_axi_rid(xbar_axi_rid[5 * ID_WIDTH_LOC +: ID_WIDTH_LOC]),
        .m_tmu1_axi_rdata(xbar_axi_rdata[5 * DATA_WIDTH +: DATA_WIDTH]),
        .m_tmu1_axi_rresp(xbar_axi_rresp[5 * 2 +: 2]),
        .m_tmu1_axi_rlast(xbar_axi_rlast[5 * 1 +: 1]),
        .m_tmu1_axi_rvalid(xbar_axi_rvalid[5 * 1 +: 1]),
        .m_tmu1_axi_rready(xbar_axi_rready[5 * 1 +: 1]),

        .perfBusy(perfBusy),
        .perfTriangleRendering(perfTriangleRendering),
        .perfRasterizerStall(perfRasterizerStall)
    );

    // Directly assign a value does not work in verilator.
    // This is an work around for the internal error: verilator Internal Error: ../V3Gate.cpp:1008: Can't replace lvalue assignments with const var
    reg tmpOne = 1;
    reg tmpZero = 0;

    assign xbar_axi_awid[4 * ID_WIDTH_LOC +: ID_WIDTH_LOC] = { ID_WIDTH_LOC { tmpZero } };
    assign xbar_axi_awaddr[4 * ADDR_WIDTH +: ADDR_WIDTH] = { ADDR_WIDTH { tmpZero } };
    assign xbar_axi_awlen[4 * 8 +: 8] = { 8 { tmpZero } };
    assign xbar_axi_awsize[4 * 3 +: 3] = { 3 { tmpZero } };
    assign xbar_axi_awburst[4 * 2 +: 2] = { 2 { tmpZero } };
    assign xbar_axi_awlock[4 * 1 +: 1] = tmpZero;
    assign xbar_axi_awcache[4 * 4 +: 4] = { 4 { tmpZero } };
    assign xbar_axi_awprot[4 * 3 +: 3] = { 3 { tmpZero } };
    assign xbar_axi_awvalid[4 * 1 +: 1] = tmpZero;
    assign xbar_axi_wdata[4 * DATA_WIDTH +: DATA_WIDTH] = { DATA_WIDTH { tmpZero } };
    assign xbar_axi_wstrb[4 * STRB_WIDTH +: STRB_WIDTH] = { STRB_WIDTH { tmpZero } };
    assign xbar_axi_wlast[4 * 1 +: 1] = tmpZero;
    assign xbar_axi_wvalid[4 * 1 +: 1] = tmpZero;
    assign xbar_axi_bready[4 * 1 +: 1] = tmpZero;

    assign xbar_axi_awid[5 * ID_WIDTH_LOC +: ID_WIDTH_LOC] = { ID_WIDTH_LOC { tmpZero } };
    assign xbar_axi_awaddr[5 * ADDR_WIDTH +: ADDR_WIDTH] = { ADDR_WIDTH { tmpZero } };
    assign xbar_axi_awlen[5 * 8 +: 8] = { 8 { tmpZero } };
    assign xbar_axi_awsize[5 * 3 +: 3] = { 3 { tmpZero } };
    assign xbar_axi_awburst[5 * 2 +: 2] = { 2 { tmpZero } };
    assign xbar_axi_awlock[5 * 1 +: 1] = tmpZero;
    assign xbar_axi_awcache[5 * 4 +: 4] = { 4 { tmpZero } };
    assign xbar_axi_awprot[5 * 3 +: 3] = { 3 { tmpZero } };
    assign xbar_axi_awvalid[5 * 1 +: 1] = tmpZero;
    assign xbar_axi_wdata[5 * DATA_WIDTH +: DATA_WIDTH] = { DATA_WIDTH { tmpZero } };
    assign xbar_axi_wstrb[5 * STRB_WIDTH +: STRB_WIDTH] = { STRB_WIDTH { tmpZero } };
    assign xbar_axi_wlast[5 * 1 +: 1] = tmpZero;
    assign xbar_axi_wvalid[5 * 1 +: 1] = tmpZero;
    assign xbar_axi_bready[5 * 1 +: 1] = tmpZero;

endmodule
