ToNi3141/Rasterix/(commit log)

2021-10-06 Almost working version on the xilinx (only streaming). Textures are not working. Probably it does not work because of the stream fix.
    [top.v]
2021-10-13 Framebuffer Fix
2021-10-13 Fix display controller tready signal
    [DisplayController8BitILI9486.v]
2021-10-21 Add FT2232 bus connector to use the RasteriCEr with a PC
2021-10-24 Filtering commands with empty counter
2021-10-30 Rework texture handling in the software
    [topMemory.v]
2021-11-01 Enable threads to improve performance
2021-11-04 Rename PreCommandParser in DmaStreamEngine and rework the command definitions
    [DmaStreamEngine.v, top.v, topMemory.v]
2021-11-04 Changes to use the RasteriCEr with an ft245 and 64kB of framebuffer ram
2021-11-05 Fix errors on the xilinx build script
    [top.v]
2021-12-05 First test on xilinx hardware. There a small issues with the textures like distortions and it seems, that it is off by 2-4 pixel
    [DualPortRam.v, FragmentPipeline.v, TextureBuffer.v]
2021-12-11 Replace doublicated code with a generic module
    [AttributeInterpolator.v, FragmentPipeline.v, RasteriCEr.v]
2021-12-12 Implement driver for smooth shading and z buffering
2022-02-15 Moving LUT generation into the IceGL class and fixing bugs in the verilog code
    [CommandParser.v, FunctionInterpolator.v]
2022-03-24 Add autoload feature to the dma stream engine
2022-03-25 fix vivado compile errors and reduce logic consumption when using the auto load function
    [DmaStreamEngine.v]
2022-04-02 Revert everything in the dvi_framebuffer.v and only add the timings for the 1024x600 display and add a Dvi wrapper to use it in the xilinx block diagram
    [Dvi.v]
2022-04-21 Add glOrtho() and fix build issues
    [topMemory.v]
2022-04-25 Implement the new TextureBuffer which reads a pixel quad. And also prepare the fragment pipeline for the filtering delay
2022-04-25 fix compile errors on vivado
    [TextureBuffer.v, TrueDualPortRam.v]
2022-04-26 Implement texture filtering
2022-04-27 Add clamping to the texel quad to avoid pixel bleeding
    [TextureBuffer.v]
2022-04-27 Add unittests for the texture buffer clamping and fix the clamping
    [TextureBuffer.v]
2022-04-28 Fix the clamping. Clamping is now coupled to a texture, not to global state anymore
    [CommandParser.v, FragmentPipeline.v]
2022-04-29 Add option to enable and disable the texture filtering
2022-05-11 Small code changes and fixing unittests
    [ColorInterpolator.v, FrameBuffer.v, TextureBuffer.v]
2022-05-15 Fix vivado compile error
    [FragmentPipeline.v]
2022-05-21 Fix PixelUtil naming bug and remove the pixel expansion from the texture buffer
    [FrameBuffer.v, TextureBuffer.v]
2022-05-26 Replace fog calculation with the ColorInterpolation (which is doing the same)
    [ColorInterpolator.v, FragmentPipeline.v]
2022-06-01 Move framebuffer acces, blending and testing into the FramebufferPipeline
2022-06-01 Fix vivado build and destress timing in the framebuffer
    [ColorBlender.v, FrameBuffer.v, FramebufferPipeline.v]
2022-06-14 Rename FramebufferPipeline into PerFragmentPipeline and rename FragmentPipeline into TextureMappingUnit
2022-07-08 Fix tex env dot calculation
    [ColorMixerSigned.v, TexEnv.v]
2022-08-06 Implement combiner in the driver
2022-08-14 Rename constants in the display list assembler
2022-08-24 the verilator make will now build by default the memory version and fix a size warning in the framebuffer
    [FrameBuffer.v]
2022-09-11 Divide a glDrawObject into several small objects to reduce the memory footprint
2022-09-18 Implement a feature enable feature to ease the software driver
2022-09-18 Increase the stream counter with to prevent overflows
    [CommandParser.v]
2022-09-19 Remove unused members and move color material stuff into the vertex pipeline
2022-10-02 Remove perspective correct color interpolation
    [AttributeInterpolator.v]
2022-10-07 Implement scissor in hardware. The scissor implementation is currently missing on clear
    [AttributeInterpolator.v, CommandParser.v, FrameBuffer.v, PerFragmentPipeline.v, PixelPipeline.v, Rasterizer.v]
2022-10-09 Add some documentation and destress the timing to get through the synthesis without timing issues.
    [Rasterizer.v]
2022-10-11 Implement complete scissoring in the framebuffer
2022-10-12 Document the (performance) limints of the scissor in the Framebuffer
2022-10-15 Framebuffer color depth is now configurable as parameter and the framebuffer stream uses the RGB565 format
2022-10-15 Rework static memory interface to reduce bram consumption
    [DisplayControllerSpi.v, DualPortRam.v, FrameBuffer.v, TextureBuffer.v, TrueDualPortRam.v]
2022-10-18 fix compile errors in vivado
    [TextureBuffer.v]
2022-10-19 Fix repetition in RGB565TO8888 converter in TextureBuffer
    [TextureBuffer.v]
2022-10-26 Implement second TMU in hardware. Software part is still missing
    [AttributeInterpolator.v, CommandParser.v, PixelPipeline.v, TextureMappingUnit.v]
2022-10-31 Several fixes to bring multitexturing to work (not yet done...)
    [CommandParser.v, PixelPipeline.v]
2022-11-28 Fix dot product sum (the sum must be multiplied by four)
    [TexEnv.v]
2022-11-28 Make texture filtering OpenGL compliant
2022-11-28 Disable texture shifting when filtering is disabled
2022-12-11 Fix texture sampler unittests
2023-01-03 Fix crashes and build problems
    [mainwindow.h]
2023-01-11 fix framebuffer address in block design
2023-01-26 Combine DMA and Render Core
2023-01-29 Remove parameters to set the resolution in the framebuffer and rasterizer
2023-02-03 Rework DMA Stream Engine
    [DmaStreamEngine.v]
2023-02-04 Use DmaStreamEngine to stream to the framebuffer stream
2023-02-04 Stream Framebuffer directly into memory
2023-02-08 Update block design and fix minimal example
    [main.cpp]
2023-02-11 Make TMU count configurable in the driver
2023-02-14 Rework framebuffer management
2023-02-18 Rework memory management in display list assembler and cleanup error management
2023-02-20 Implement arduino renderer class
2023-02-20 switch to c++20 and remove tcb/span
2023-02-23 Prepare rp2040 build with pico-sdk. Drop Arduino build to support C++20.
2023-02-28 Fix pico example
2023-03-03 Use the clear to send signal in the bus connector to upload big display lists in the rp pico example.
2023-03-17 Function interpolator32 bit streams (#39)
    * Implement 32 bit streams for the function interpolator
    * Reduce the bit width of the cmod version to reduce the logic count
    * Reduce the bit width of the cmod version to reduce the logic count
    * fix glColor variants
    * fix build under windows
    ---------
    [Cmod-A7-Master.xdc, CommandParser.v, FunctionInterpolator.v]
2023-04-11 Implement stencil buffer (#41)
    * Refactor pixel conversion
    * Implement stencil buffer
    * cleanup testscene
    * Update readme
    * refactor examples and add stencil shadow example
    * Fix warnings and improve rasterizer quality
    * Fix build on windows
    * cleanup
    * Fix display in landscape mode
    * add stencil shadow description
    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
    [CommandParser.v, DisplayController8BitILI9341.v, FrameBuffer.v, PerFragmentPipeline.v, PixelPipeline.v, StencilOp.v]
2023-06-03 Zynq port (#42)
    * Add Zynq port
    * update zynq build script
    * add kernel object build
    * Implement zero copy dma
    * port simulation to new interface
    * port simulation to new interface
    * port rp2040 bus connector
    * port ft600 bus connector
    * update the cmod A7 and Nexys Video build
    * Cleanup
    * Update all designs to vivado 2022.2
    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
2023-06-25 Restructure buildsystem (#43)
    * Restructure build system
    * fix dma-proxy build and add framebuffer and USB to the device tree
    * add bsp config
    * optimize memory and fix issues with big triangles
    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
2023-11-09 Rework framebuffer (#45)
    * Add MemoryReadRequestGenerator
    * Framebuffer Serializer WIP
    * Implement FramebufferSerializer
    * Move the PerFragmentPipline from the PixelPipeline to the RasterixRenderCore
    * fix osx build
    * Move framebuffers from RasterixRenderCore to Rasterix
    * Implement axi like interface to the framebuffer
    * Implement stream concatenation
    * Add stream broadcast and tlast / tkeep signals for the framebuffer
    * implement framebuffer writer
    * Reduce the strobe to one bit per fragment, because the mask handling is done in the framebuffer
    * fix address handling in the serializer
    * Reduce delay of the memory request generation of the MemoryReadReque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
    [AttributeInterpolator.v, ColorBlender.v, ColorInterpolator.v, CommandParser.v, Dvi.v, FrameBuffer.v, FramebufferReader.v, FramebufferSerializer.v]
2023-11-19 Optimize utilization (#46)
    * Implement the following measures:
    - Use the optimized float library
    - Reduce the float precision from 32bit to 24 bit in the AttributeInterpolator (no visible effect, even lower values seem to be possible, reducing to 20bit frees another 1000 LUTs)
    - Disable FiFo in the StreamConcatFifo when it is not needed
    This measures resulted in a decrease of 3000 to 4000 LUTs and also a decrease in the DSP consumption of around a half.
    * cleanup interfaces
    * cleanup code
    * Move code in the RRXC around
    * remove unused flow control ports
    * 24 bit will show on close objects a visible distortion and jagging of textures. So put it back to 32 bit precision. I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
2023-12-07 Glx (#48)
    * First, with SDL2 working glX version
    * fix rrxef build
    * fix depth range calculation
    * Update readme and create a OpenGL32.dll while building wgl
    * enable logging for glXGetProcAddressARB
    * Consider new stream sections in the displaylist size check
    * Implement swapping for framebuffer for rrxif (only zynq works, others needs to be adapted)
    * Use only one display list so configure the display output
    * Fix display list swapping on rrxef variant
    * Enable swapping in both renderer drivers
    * Fix CMod7 hardware
    * fix simulation
    * Fix nexys build
    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
    [CommandParser.v]
2023-12-14 refactor texture sampler
2023-12-16 Rework texture sampler
2023-12-16 fix wrongly interpolated pixel
    [TextureSampler.v]
2023-12-18 fix the lod calculation in the texture sampler
    [TextureSampler.v]
2023-12-28 Reduce memory footprint of a mipmap
2023-12-31 Add mipmapping to the driver
2023-12-31 Fix sampling of textures when a 256x256 texture is used
    [TextureSampler.v]
2024-01-03 Fix texture clamping by using the old algorithm to clamp ...
    [TextureSampler.v]
2024-03-08 Implement fixpoint interpolator (#53)
    * Move float to fixpoint conversion out of the pixel pipeline
    * Add fix point interpolator. Including mipmapping it requires around 8.5k LUTs
    * Fix fog calculation in fixpoint interpolator
    * Fix fog calculation and texture interpolation
    * Use screen coordinates in the rasterizer instead of the bounding box coordinates
    * Add documentation and make the calculation precision configurable
    * Fix warnings
    * Refactor names and cleanup code
    * fix perspective correction on texture 0 (offset of one clock)
    * Fix fogging when unknown pname is used
    * Fix build scripts
    * Simplify configuration by defining that only the fixed point vers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
    [AttributeF2XConverter.v, AttributeInterpolationX.v, AttributeInterpolator.v, AttributeInterpolatorX.v, AttributePerspectiveCorrectionX.v, PixelPipeline.v, Rasterizer.v, StreamSemaphore.v]
2024-04-28 Refactor driver (#54)
    * Move viewport into own class
    * Implement a matrix stack to handle the different matrices
    * Move color material color tracking into the lightning class
    * Move culling into own class
    * Move primitive assembly into own class
    * Fix typo
    * Improve performance
    * increase performance
    * move texture object into own file
    * Remove unnecessary redefinitions
    * Move fog calculation into own class
    * Move texture handling into own class
    * Move stencil into own class
    * Move fragment pipeline stuff into own class
    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
    [mainwindow.cpp, mainwindow.h]
2024-05-14 Performance optimizations (#55)
    * Optimize clipping algorithm
    * Reduce copying of data when no clipping is necessary
    * slightly improve the performance of the rasterizer
    * Remove oow parameter (its already in the Vec4)
    * use special type for the transformed triangle
    * fix build
    * Use more inline
    * Improve the performance of the TriangleStreamCmd when only one TMU is available
    * adapt compiler switches
    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
2024-07-17 Add device configuration via buildsystem (#56)
    * Use CMake to set the hardware configuration on the software library
    * Remove variant selection
    * rename IceGL into RRXGL and restructure the code
    * Fix TopRRXEF and increase the AddrWidth of the DmaStreamEngine to 32 bit
    * Fix hangup when stencil buffer is disabled
    * Add framebuffer reader
    * Fix windows build and other build problems
    * Add toolchain as part of the zynq preset
    * fix glx build
    * Update zynq presets to make them better reusable
    * Add busconnector for the xilinx cdma
    * Add RRX prefix to cmake configuration parameters
    * Add 16 bit output to the DisplayFramebufferReader
    * Rem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
    [DisplayController8BitILI9486.v, DmaStreamEngine.v, mainwindow.cpp, mainwindow.h]
2024-08-20 Cmod7a (#57)
    * rework cmod 7a block design to use the rrxef. add a custom sram controller, because the xilinx one is too slow.
    * Fix a few synthesis warnings
    * adapt pinout
    * optimize block design
    * Update picture
    * update readme
    * add comments
    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
    [AsyncSramController.v, AsyncSramPhy.v, AttributeInterpolationX.v, AttributeInterpolatorX.v, AttributePerspectiveCorrectionX.v, Cmod-A7-Master.xdc, ColorMixerSigned.v, DisplayController8BitILI9341.v]
2024-09-09 Platformio support (#58)
    * add tcb span to the repository
    * Reduce c++ version to 17 and using tcb span instead. this should make it compatible with arduino
    * add library.json
    * mend
    * Add example
    * remove unused files
    * Remove if constexpr to add compatibility with older c++ standards
    * Update pio example
    * Remove redefinitions of min/max
    * Switch include position to avoid compile errors (Arduino.h defines min/max macros)
    * Remove unused includes
    * Fix builderror with petalinux
    * fix simulation build
    * Remove likely and unlikely attributes
    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
    [main.cpp]
2024-10-22 Performance optimizations (#59)
    * Some performance optimizations
    * resolve warnings
    * Add sampling SPI and fix build errors
    * Remove unused file
    * Add intermediate displaylist upload when only one is used and the displaylist is full
    * fix uploading
    * Fix framebuffer handling when using EXTERNAL_MEMORY_DOUBLE_BUFFER
    * optimize memory consumption when using external framebuffers
    * update external framebuffer sizes
    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
    [Serial2AXIS.v, SpiSlave.v, main.cpp, mainwindow.h]
2024-11-23 Add spi interface to nexys board (#61)
    * add SPI port to the nexys board
    * Update library.json
    * Reduce SPI clock speed in examples
    * Fix StreamSemaphore
    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
    [FT245S2AXIS.v, FunctionInterpolator.v, MainInterface.v, Nexys-Video-Master.xdc, StreamSemaphore.v]
2024-11-25 Fix holes in mesh (#62)
    * fix holes in the mesh when rendering
    * Update nexys rrxef design
    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
    [Rasterizer.v, StreamSemaphore.v]
2024-11-27 Fix stream semaphore (#63)
    * Fix wrong counting of the stream semaphore
    * typo
    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
    [StreamSemaphore.v]
2024-12-03 Add hardware to convert from float to fixpoint (#64)
    * Add hardware accelerated float to fixpoint converter
    * Adapt driver to use by default the float interpolation
    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
    [AttributeF2XConverter.v, AttributeInterpolator.v, AttributePerspectiveCorrectionX.v, CommandParser.v, Rasterizer.v, RegisterBank.v, TriangleStreamF2XConverter.v]
2024-12-22 Texture loader (#67)
    * Add texture reader
    * Remove template argument from TextureStreamCmd
    * Refactor command handling
    * Fix skid buffer in command parser
    * Prototypic integration of the texture reader
    * Fix vivado errors and stucking renderer when only one tmu is configured
    * add rrx wrapper
    * add adapter to downsize the framebuffer stream
    * Adapt zynq build
    * fix warnings
    * Add ef variant
    * Remove unused parameter
    * Porting the current boards to the RRX wrapper
    * Update documentation
    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
    [AsyncSramController.v, CommandParser.v, Fog.v, FrameBuffer.v, FunctionInterpolator.v, PagedMemoryReader.v, PixelPipeline.v, TextureBuffer.v]
2024-12-30 Refactor flow control (#68)
    * Refactor PerFragmentPipeline output interface and use AXIS broadcast to distribute the data to the FIFOs
    * Cleanup PerFragmentPipeline interface
    * Add to all modules a clock enable signal and back pressure the flow control. Remove the old flow control mechanism
    * Fix flow control
    * Add skid buffer to the texture sampler
    * Make the FIFOs configurable
    * Update design
    * Fix unittests
    * Remove unused modules
    * Some fixes and findings
    * Update float library
    * Refactor TMU and the pixel pipeline
    * Increase read fifo size to fix floating point interpolation
    * Cleanup perspective correction
    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
    [AttributeF2XConverter.v, AttributeInterpolationX.v, AttributeInterpolator.v, AttributeInterpolatorX.v, AttributePerspectiveCorrectionX.v, ColorBlender.v, ColorInterpolator.v, ColorMixer.v]
2025-01-25 Refactor display list handling (#69)
    * Update command types and refactor DSE command handling
    * Move DSE and RRX stuff into own display list handlers
    * Move texture loading optimization into own file
    * Renaming
    * Add stream section manager
    * Use for the StreamSection Manager a DSE command
    * Use namespace for the display list files
    * Move the stream section handling from the display list assembler to the renderer
    * Refactor command handling in the renderer to generalize it
    * Moe code into a display list dispatcher and double buffer handler
    * Cleanup renderer
    * fix build error with vs studio
    * Move the instantiation of the displaylists to the renderer
    * A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
2025-02-11 Performance optimization2 (#72)
    * Try to help the compiler to vectorize the code
    * Disable autovectorization. It actually makes the code slower and not faster...
    * Use vmul and vadd instead of vmla to reduce data dependencies in neon assembly
    * format
    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
2025-02-23 Refactor framebuffer handling (#73)
    * Transfer framebuffer size via framebuffer cmd
    * Emulate a commit in the EF configuration
    * Move the chip managing stuff like the adapters and DSEs out from the RasterixxF to the RRXxF modules
    * Add framebuffer reader/writer to the RRXIF and RRXEF
    * Cleanup the hardware implementation
    * Rename WORDS info PIXEL
    * Rename WORDS info PIXEL
    * Unify the texture config
    * cleanup renderer
    * Add default color buffer location
    * fix windows build issue
    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
    [AxisFramebufferReader.v, CommandParser.v, FrameBuffer.v, TextureBuffer.v, top.v]
2025-02-26 Refactor dse driver (#75)
    * Refactor DSE driver
    * fix windows build
    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
2025-03-05 Threaded rasterization (#76)
    * Use lambda instead of class
    * Remove display list dependencies
    * Add IDevice interface
    * Add threaded renderer
    * Cleanup triangle handling
    * Update readme and cleanup
    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
2025-03-11 Refactor pixel pipeline interface (#77)
    * Use directly the register classes
    * Move the enums into a common header
    * Completely hide the renderer behind the pixel pipeline
    * clamping
    * Move texture pixel conversion into own file
    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
2025-03-18 Vsync (#78)
    * use two framebuffers for the rrxif
    * Implement vsync
    * add vsync also as compile option
    * Fix display list ordering
    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
    [CommandParser.v, Dvi.v, top.v]
2025-04-05 Threaded transforming (#85)
    * Split transforming and fetching
    * Move stencil to the vertex pipeline
    * Separate setter and calculation code
    * Split transformations into setter, data and calc
    * Split matrix store into a data object
    * Cleanup texgen
    * Move transforming code into own class
    * Move vertex transformation into the renderer
    * Fix lighting and remove unused code
    * fix normalizing
    * Remove pixel pipeline dependency from the stencil
    * Move transform classes into own subdirectory
    * Use the matrices struct in the texenv, because of a bug (in the compiler?). It is not possible to use specific matrices. The model view matrix is for unknown reason broken and the transformation mo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
2025-04-06 Thread abstraction (#86)
    * Use thread abstraction
    * Enable intermediate while threading is enabled
    * Add destructors
    * fix platformio build
    * Move the thread runners into own folder
    * Fix windows build
    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
    [main.cpp, mainwindow.cpp, mainwindow.h]
2025-04-13 Remove intermediate upload in the threaded rasterizer (#90)
2025-05-24 Utilization optimization (#91)
    * Optimize color mixing by adapting the calculation precision. Saves around 1500 LUTs with almost no visible degradation
    * Make filtering, fogging and depth buffer also configurable. Disabling all features can save additional 4500luts
    * Fix build
    * use 6 bit for the rixif on the zynq
    * Add a external parameter to configure the sub pixel calculation precision
    * Revert "use 6 bit for the rixif on the zynq"
    This reverts commit defaa4f583185cac337d63d8b1c64869a95a015e.
    * Update simulation
    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
    [ColorBlender.v, ColorInterpolator.v, ColorMixer.v, ColorMixerSigned.v, Fog.v, PerFragmentPipeline.v, PixelPipeline.v, RasterIX.v]
2025-06-09 Threaded rasterizer with rixif (#92)
    * Fix scissor
    * Move the multi display list handling into a thread
    * Add uploader to the other modules and rename SingleThreadRunner into NoThreadRunner
    * Fix rendering on zynq
    * Move thread into ThreadedRasterizer and fix some bugs
    * Remove unused display list
    * Use std thread and configure its priority to start it before the main thread is continued
    * Fix example
    * logging
    * add default line width
    * Fix deadlock under windows
    * formatting
    * fix build error
    * Fix initialization in Dvi module
    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
    [Dvi.v, main.cpp, mainwindow.cpp, mainwindow.h]
2025-06-14 Cleanup (#93)
    * Refactor IBusConnector interface
    * Change the function signature of a thread from bool() to void()
    * Update some names
    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
2025-06-21 Display list disassembler (#94)
    * Remove unused command
    * Create DisplayListDisassembly class and move the code from ThreadedRasterizer into this class
    * Use variant for registers
    * Rename DisplayListCommands into CommandVariant
    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
2025-07-05 Decouple texture loading from main thread by adding a page list. This… (#95)
    * Decouple texture loading from main thread by adding a page list. This list is loaded before the new transformed display list is rendered and does not anymore blocks the main thread to upload texture data.
    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
2025-07-30 Refactor internal framebuffer (#96)
    * Split the internal framebuffer into its components
    * Separate the address generator from the DMA Stream Engine
    * remove framebuffer stream from verilator top file, and cleanup code
    * Refactor internal framebuffer command handler
    * Refactor the scissor in the command handler
    * Generate strobe signal
    * refactor AxisFramebufferWriter
    * Add strb signal
    * cleanup test
    * Remove unused address generator in the dma stream engine
    * Gneralize the AxisFramebufferWriter to work in both directions with AXIS and AXI
    * Rename AxisFramebufferWriter into AxisToAxiAdapter
    * use an separate address channel to trigger a memory write
    * Rename signals to make cle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
2025-08-07 Improve context handling (#98)
    * Move all operation codes into own file
    * Refactor PushVertexCmd and SetVertexCtxCmd
    * Split VertexCtx into three smaller ctx
    * Reduce the page size of the nexys config and make the display list size configurable
    * Rename display list parameter
    * Fix broken rendering when threaded rasterization is disabled (lighting context was send by accident)
    * Improve framebuffer handling when using the simulation
    * Disable min filter by default
    * Only enable mipmapping when mip mapping is available
    * refactor vertex context handling
    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
2025-08-09 Logic op (#99)
    * Rename some wires in the fragment pipeline
    * Implement glLogicOp
    * Unittest logic op
    * Cleanup logicOp implementation
    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
2025-08-15 Implement clip plane (#100)
    * Refactor matrix handling
    * Disable neon transformation because of alignment issues
    * Add clipping helper
    * First working version of the clipping plane
    * Fix tex gen
    * Fix GL_LINES by separating the line construction from the primitive assembler to an line assembler. Add dedicated clipping methods to the clipping plane
    * remove warning
    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
2025-09-08 Copy tex image (#103)
    * first working version with the simulation to copy data from the color buffer into a texture
    * WIP working texture copy on zynq if
    * Fix segfault when overwriting a small texture with a big texture during glTexImage2d and glTexSubImage2d
    * improve reading from device memory
    * implement glCopyTexSubImage2d
    * Move memory allocation for textures into glTexImage2D
    * Remove const
    * implement GL_UNPACK_ALIGNMENT
    * Rename in IntendedInternalPixelFormat into InternalPixelFormat
    * Rename texture converter to image converter
    * implement glReadPixels
    * Update block designs
    * Check if a load buffer is available
    * F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
    [MainInterface.v, RasterIX.v, RasterIX_EF.v, RasterIX_IF.v, Serial2AXIS.v, main.cpp, top.v]
2025-10-02 Vbo (#108)
    * add vertex buffer object
    * Integrate methods to create, bind, delete, ... a VBO
    * Integrate the VBOs into the vertex pointers and drawElement
    * Fix VBOs
    * add vbo example
    * add the VBOs to the lib procedures
    * Make the max VBO count configurable via cmake
    * Correct platformio build
    * fix rppico vbo build
    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
    [main.cpp]
2025-11-04 Memory optimizations (#109)
    * memory optimizations
    * Improve multi line handling by resetting context of the new line to the context of the end of last frame.
    Improve intermediate upload (note: it is only working with the EF config correctly, the IF config fails, because it does not store the depth/stencil buffer into memory).
    * fix intermediate upload
    * fix depth and stencil buffer upload
    * add performance mode where the depth buffer and stencil buffer are not saved/loaded
    * fix lighting and fix stencil buffer address
    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
    [AxisToAxiCrossbar.v, RasterIXCoreIF.v, RasterIX_IF.v]
2025-12-09 Gl enable (#111)
    * Add all missing glEnable symbols
    * add getters to the vertex array
    * Implement glIsEnabled
    * Move point sizes to the vertex parameters
    * implement glPointSizePointerOES
    * glIsTextrue
    * glClipPlane
    * glGetLightfv
    * getMaterial
    * glGetPointerv
    * Fix gamma on the ILI9341 display
    * glGetTexEnv
    * Update opengl version string
    * glGetTexParameteriv
    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
    [DisplayController8BitILI9341.v]
2026-01-28 Software rasterizer (#113)
    * rename directory
    * WIP: It is capable to clear the screen and to draw triangles. Texturing, blending and so on is not working yet.
    * add interpolator
    * fix depth buffer
    * TestFunc
    * Add offset to the busconnector to upload only certain parts of a buffer
    * Add texture unit
    * TexEnv
    * fog
    * blend func
    * LogicOp
    * StencilOp
    * fix framebuffer
    * some cleanups
    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
    [AttributePerspectiveCorrectionX.v, AxisFramebufferReader.v, AxisToAxiCrossbar.v, ColorBlender.v, FrameStreamingCore.v, PerFragmentPipeline.v, RasterIX_EF.v]
2026-02-17 Multicore software rendering (#114)
    * Add capability that the software renderer can split the screen in lines as preparation for multicore rendering
    * Performance optimizations (roughly 2x)
    * Add threaded software rasterizer
    * Try to fix raceconditions
    * Add some performance improvements
    * continue optimizing the performance
    * Fix framebuffer
    * cleanup SoftwareRasterizer instantiation
    * Fix wgl integration
    * Fix rendering when there are more threads then display lines
    * Update readme, preset and fix some build issues
    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
    [mainwindow.h]
2026-05-23 Axi coalescer (#116)
    * Add CoalesceFiFo
    * add address generator
    * Integrate and fix
    * fix vivado build
    * Refactor rasterizer with a left to right rasterization only
    * Optimize axi transfer by setting better cache settings and axi_adapter config
    * Split StreamFramebuffer in several components
    * fix tests
    * Refactor CoalesceAddrGen
    * Fix deadlock via a semaphore when too many pixels of the same framebuffer are requested
    * Integrate Coalescer
    * Move FramebufferReader and FramebufferPacker into a generic FramebufferAdapter module. Remove the address config from FramebufferReader and instead using a MMU similar to the write channel
    * upgrade to Verilator 5.046 2026-02-28 re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
    [AttributeInterpolationX.v, AttributeInterpolator.v, AttributePerspectiveCorrectionX.v, AxisFramebufferReader.v, AxisMemoryReader.v, CoalesceAddrGen.v, CoalesceFiFo.v, Coalescer.v]
2026-06-21 Te0890 (#117)
    * Add TE0890 build target
    * Remove write FIFOs. Obsolete because of the coalescer
    * fix missing 1x1 mipmap level
    * improve performance by avoid unnecessary memory requests
    * Update readme and preset
    * remove framebuffer enable command (obsolete by using valid and strobe)
    * Fix broken mutithread rendering by correctly initializing the FogLutStreamCmd
    * RenderState captures now TMU register contents
    * add multicore rendering to the pico
    * Several bugfixes fixing the texture upload and vsync
    * add 3d labyrinth demo
    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
    [AttributeInterpolationX.v, AxiToAvalonBridge.v, CameraPathController.hpp, HyperRamPhy.v, HyperRamWrapper.v, InternalFramebuffer.v, InternalFramebufferWriter.v, Labyrinth.hpp]
2026-08-09 Fixes (#118)
    * update glx, FPGA reduce build size
    * fix intermediate upload in threaded rasterizer
    * reduce log level
    * reduce page size to 2048
    * Improve glx implementation
    * add performance signals
    * add small vertex cache to improve vertex transformation performance
    * Improve specular light performance
    * Optimize dataflow in the vertex transformer
    * Fix clipping and optimize matrix transformations when clipping is used
    * Improve clipping and calculate the texture transformation only when the matrix is not an identity matrix
    * optimize rasterization
    * add direct call from the DisplayListDisassembler to the handlers instead of a roundtrip via std::variant
    * add direct call fro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
    [Arty-Z7-20-Master.xdc, CommandParser.v, Dvi.v, FrameStreamingCore.v, PagedMemoryReader.v, RasterIX.v, RasterIXCoreEF.v]
2026-09-18 Optimize framebuffer (#119)
    * Optimize cleaning in the external framebuffer config
    * Move coalescer bypass into coalescer
    * Move coalescer into StreamFramebuffer
    * Reduce rasterizer utilization in EF mode
    * Update some parameters
    * some fixes
    * Increasing the size of the fixpoint multiplication from 18 bit to 24 bit to avoid overflows
    * fixing wobbling textures when q/w is big by dynamically shifting q in the fix point interpolator and fixing broken interpolations on some narrow triangles
    * Fix rendering outside of the screen view port
    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
    [AttributeInterpolatorX.v, AttributePerspectiveCorrectionX.v, Coalescer.v, FramebufferWriterClear.v, RasterIX.v, RasterIXCoreEF.v, RasterIXCoreIF.v, RasterIXRenderCore.v]
2026-09-28 Texture cache (#120)
    * Add texel context management
    * Move the color conversion from the TextureBuffer into an own module
    * Move clamping into own module
    * Add TMU capabilities to work with a stalling texture buffer
    * Remove TextureClamp (not needed anymore and is already redundant)
    * Add TextureMemory module
    * Add the texture memory reader
    * Rename
    * Add direct mapped cache
    * Add texture cache context
    * Add TextureCacheDirectMapped
    * Use an axi compliant interface for the MMU
    * The whole cache only supports one address width
    * add texture cache and make it buildable with vivado
    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
    [PixelPipeline.v, RasterIX.v, RasterIXCoreEF.v, RasterIXCoreIF.v, RasterIXRenderCore.v, RasterIXSystem.v, RasterIX_EF.v, RasterIX_IF.v]
2026-10-23 Optimize utilization (#122)
    * Add more optimal ShiftRegisterBank for the triangle parameters and optimize the attribute interpolator
    * optimize fifo utilization
    * move framebuffer clear into the render core
    * Move scissor into the render core
    * fix clear bug in if mode
    * Rename Scissor and FramebufferClear
    * Optimize zynq utilization
    * Enable texture cache by default
    * use blockram in direct mapped cache
    * refactor parameter names
    * cleanup internal framebuffer
    * remove the if variant from the board files
    * move strobe generation into the render core
    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
2026-10-28 Colorbuffer swap waits for framebuffers (#125)
    * The color buffer swap waits till all data is written into the memory
    * the color buffer swap waits now also for the if config
    * Add idle signal
    * move the write transaction tracker closer to the places where the data is created
    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
